Grace-Note-LLC/GraceNote/gracenote_firmware/keyboard/README.md

**Keyboard Subdirectory**

- This subdirectory contains all documentation related to the current-running firmware on GraceNote:

  (i) This README containing information about the firmware.

  (ii) The 'KeyboardMessage.ino' Arduino sketch that runs on the latest version of GraceNote.

**The Code**

- Cody
