Grace-Note-LLC/GraceNote/gracenote_hardware/atmega328p_board/altium/README.md

**Altium Subdirectory for Custom ATMega328p-AU Board**

- This subdirectory contains all design, schematic, and pcb files used for the GraceNote ATMega328p-AU board:
