Grace-Note-LLC/GraceNote/py_ui/assets/hand-removebg-preview.png

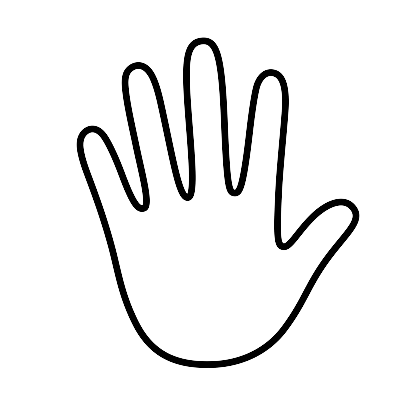
py_ui/assets/hand-removebg-preview.png
