Grace-Note-LLC/GraceNote/gracenote_hardware/esp32s3_board/altium/gracenoteESP_schematic.pdf

# Gracenote - ESP Edition

# GND¹ ²

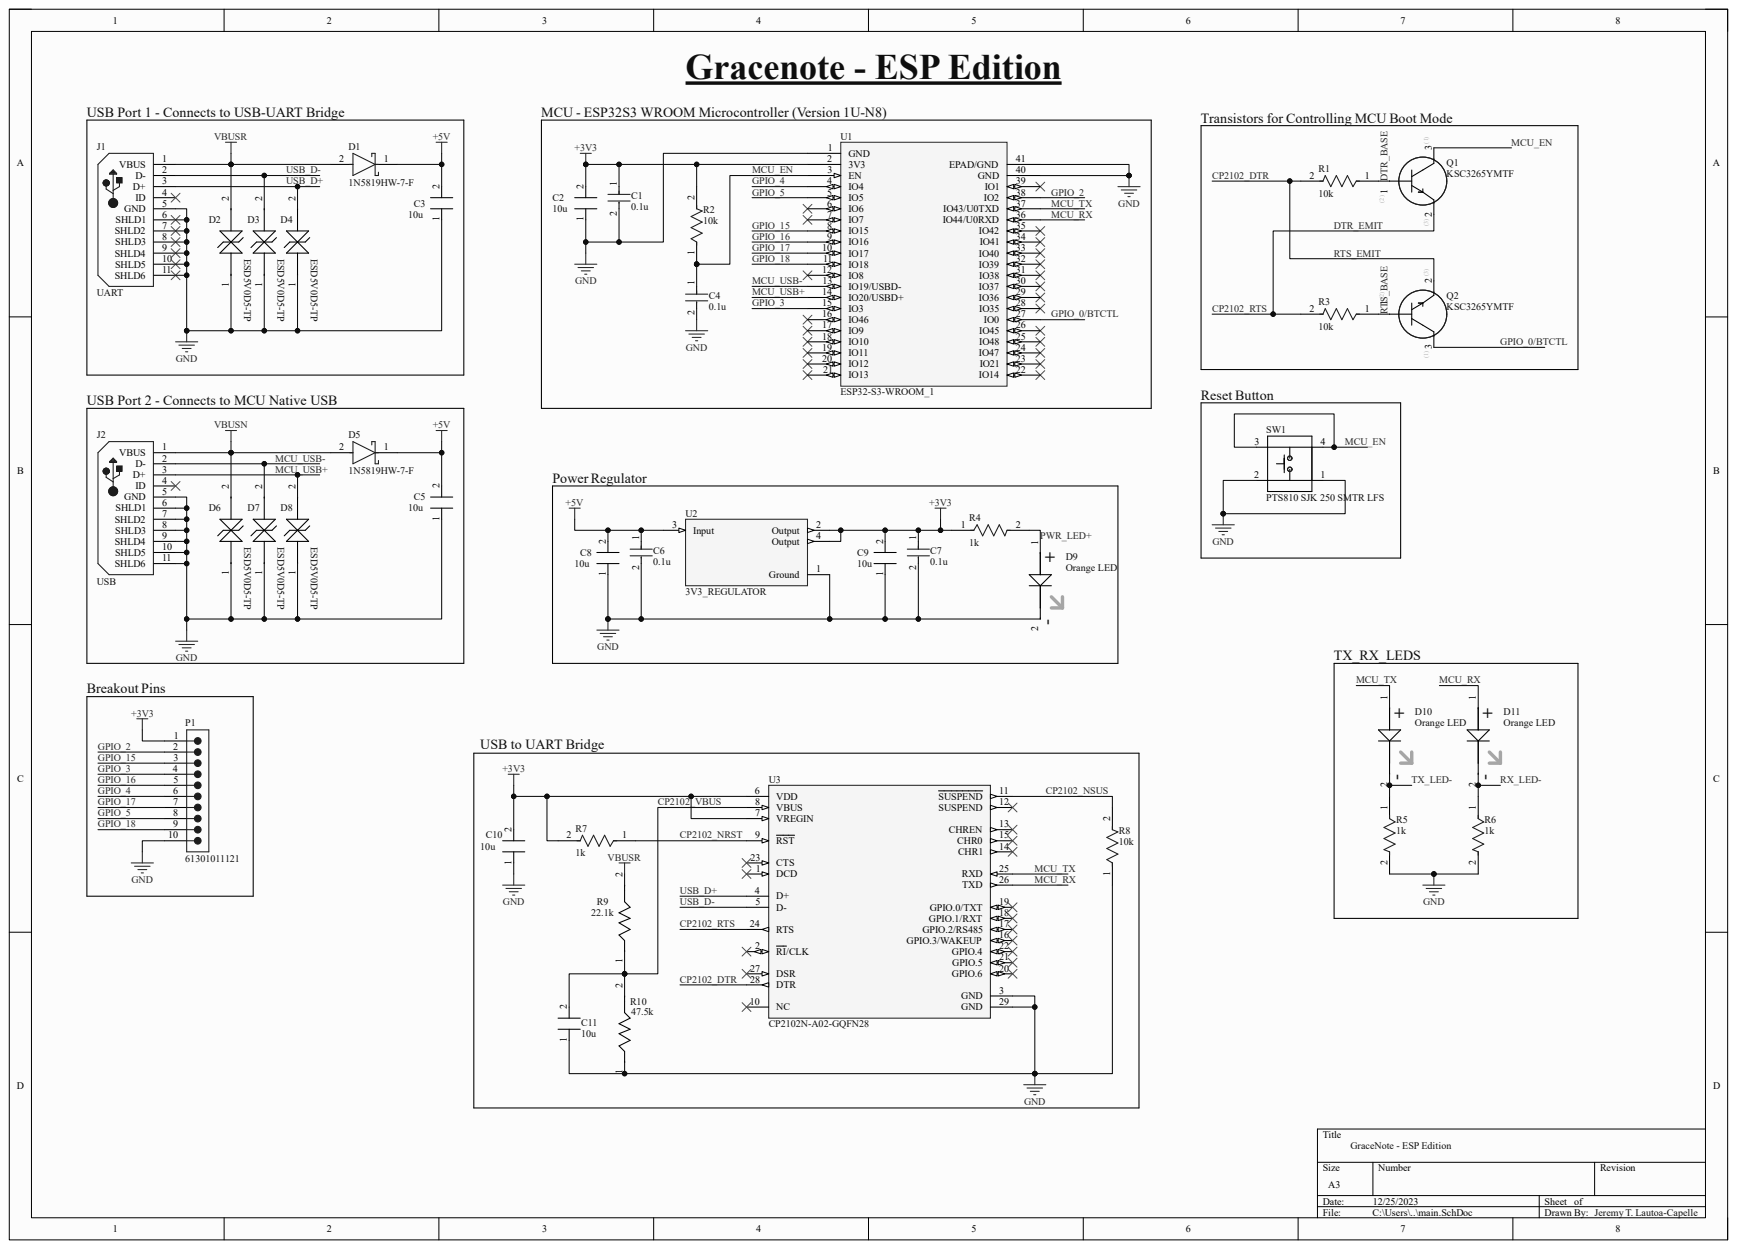
[picture p2: page 1]

USB Port 1 - Connects to USB-UART Bridge

MCU - ESP32S3 WROOM Microcontroller (Version 1U-N8)

Transistors for Controlling MCU Boot Mode
DTR_EMIT DTR_BASE RTS_BASE

USB Port 2 - Connects to MCU Native USB

USB to UART Bridge
