Grace-Note-LLC/GraceNote/gracenote_hardware/esp32s3_board/altium/gracenoteESP_PCBTOP.pdf

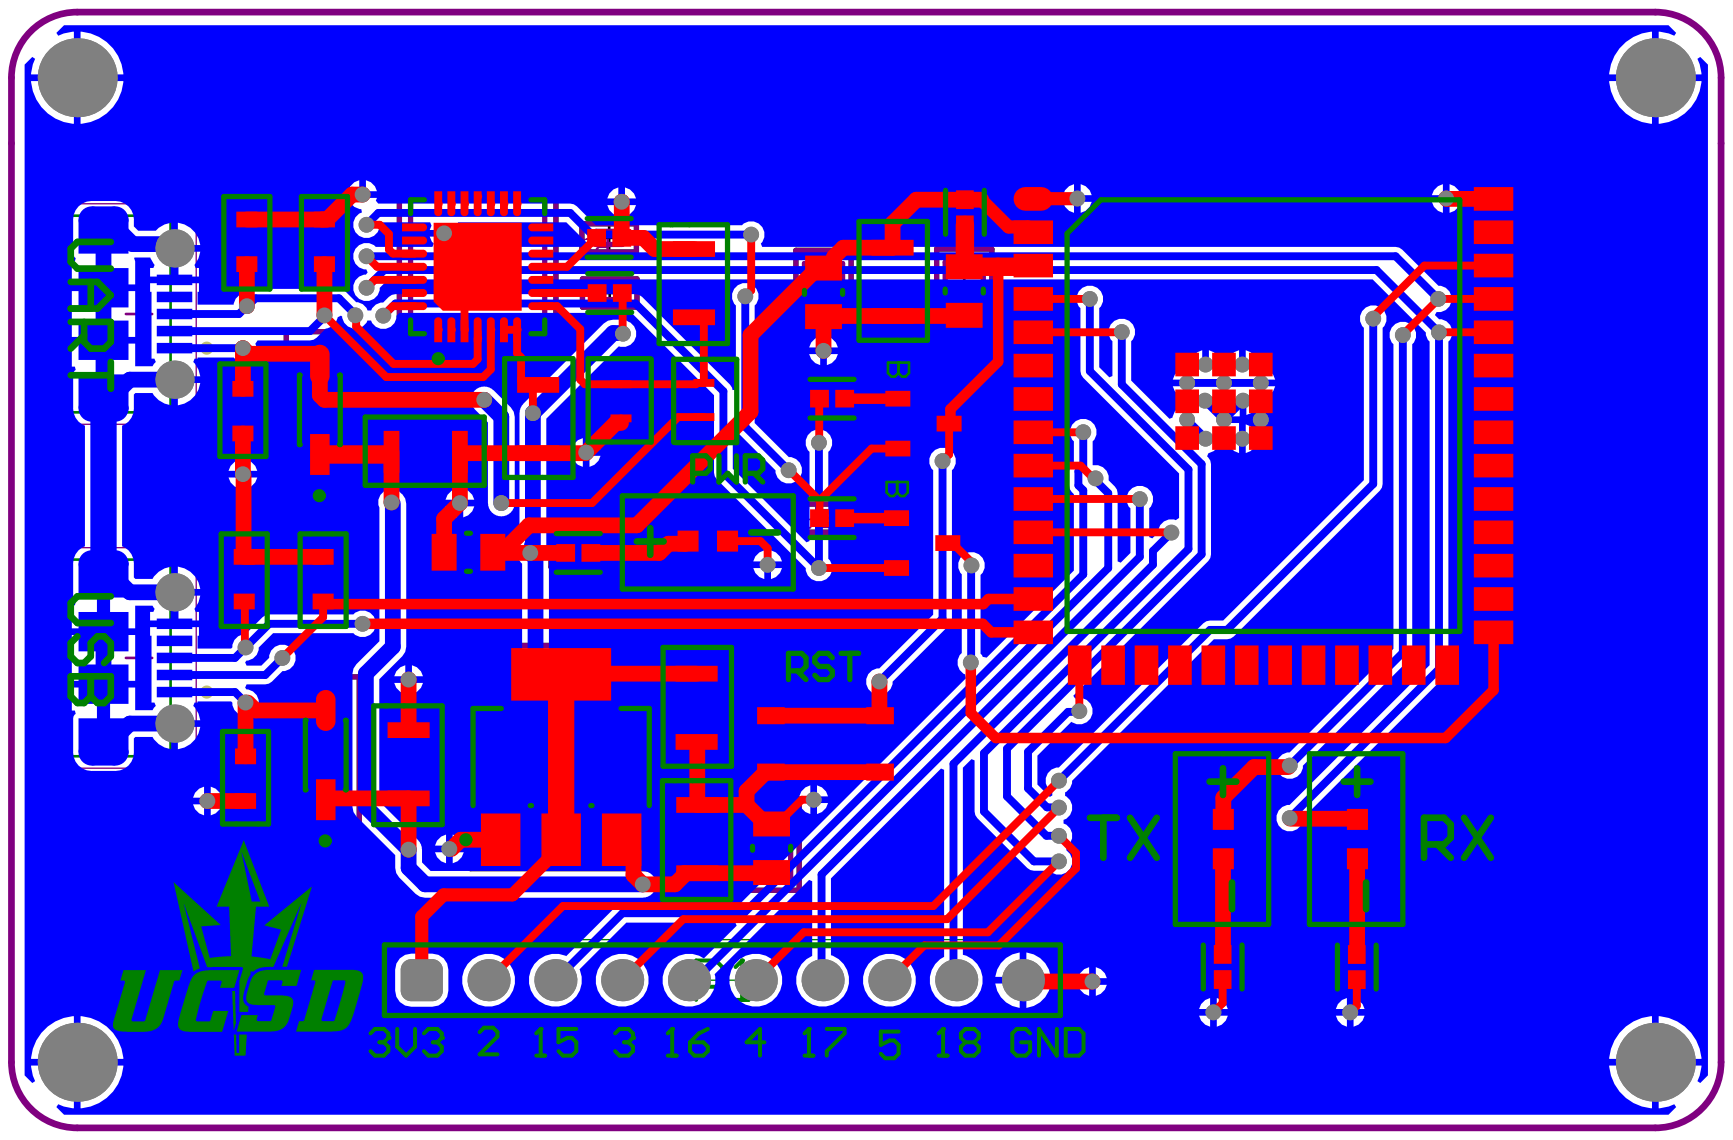
[picture p3: page 1]
