Grace-Note-LLC/GraceNote/(list of files, drawings)

Other design files:
gracenote_hardware/esp32s3_board/altium/esp32s3_wroom.PcbLib
gracenote_hardware/esp32s3_board/altium/esp32s3_wroom.SchLib
