Grace-Note-LLC/GraceNote/py_ui/portdisplays.py

import flet as ft

import serialtest
import global_var

import serial.tools.list_ports

display_box = ft.Container(
    content=ft.Text("List of Devices"), 
    padding=5,
    # bgcolor=ft.colors.RED,
    border_radius=3
)
port_list_title = ft.Container(
    content=ft.Row(controls=[
        ft.Text("Available Ports"),
        ft.Icon(
            name=ft.icons.RADIO_BUTTON_UNCHECKED,
            color=ft.colors.RED,
            size=20,
        ),
    ]),
    padding=1,
    # bgcolor=ft.colors.RED,
    border_radius=3
)
no_ports = ft.Container(
    content=ft.Text("No Devices Found"), 
    padding=5,
    bgcolor=ft.colors.RED,
    border_radius=3,
    alignment=ft.alignment.center
)

port_list = ft.ListView(padding=5, spacing=10, height=100, width=200)
port_menu = ft.Column([port_list_title, port_list], horizontal_alignment=ft.CrossAxisAlignment.CENTER)

# Loop for all available ports to find the button
def list_ports():
    print("Listing Ports")
    ports = serial.tools.list_ports.comports()
    port_list.controls.clear()
    for port, desc, _ in sorted(ports):
        if ("Bluetooth" not in "{}".format(desc)):
            print("Port Item Added: {}".format(desc))
            button = ft.ElevatedButton(
                content=ft.Text("{}: {}".format(port, desc)[0:-7], size=10),
                bgcolor=ft.colors.GREY_900,                
                on_click=lambda _, port=port: assign_port(port),
            )
            port_list.controls.append(button)
    if len(port_list.controls) == 0:
        port_list.controls.append(no_ports)

    return port_menu

# Assigns the port from a button click
# The port will be passed as a string!!!
def assign_port(port):
    print(f"\nConnect Attempt: {port}")
    try:
        global_var.ser = serial.Serial(port, global_var.baud_rate)
        # global_var.reader = serialtest.ReadLine(global_var.ser)
        print("N!O!OO!")
        print("AHAHHA")
        global_var.port_found = True
        
        print(f"Port Found: {global_var.port_found}")
        port_list_title.content.content = "Port Connected"
        global_var.page.update()

    except Exception as e:
        print(f"Attempted to Connect to Previous Port: {e}")
        list_ports()

    port_status_update()

def port_status_update():
    if global_var.port_found:
        port_list_title.content.controls[1].name = ft.icons.RADIO_BUTTON_CHECKED
        port_list_title.content.controls[1].color = ft.colors.GREEN
    else:
        port_list_title.content.controls[1].name = ft.icons.RADIO_BUTTON_UNCHECKED
        port_list_title.content.controls[1].color = ft.colors.RED
