Grace-Note-LLC/GraceNote/(commit log)

2023-10-19 add basic clicker
    adds Arduino code for the clicker module and a README to explain the device and how to use it
2023-10-22 button verication
2023-10-22 buggy button
2023-11-12 added keybinds, 5 buttons, no animations
2023-11-30 added port selector, error handling
    [hand.py, main.py, portdisplays.py]
2023-12-02 💚Got the Com button to turn green!
2023-12-03 more functionality + error dialogs
    [hand.py, main.py, portdisplays.py]
2023-12-03 added minimize button
2023-12-03 😎 Added a Theme changer icon
2023-12-03 fixed no ports dialogue
    [main.py]
2023-12-03 fixed the 6 character error that i shipped to prod
    [main.py]
2023-12-03 fixed send input dialog box, single input verify
    [hand.py, main.py]
2023-12-03 added responsive buttons + presets, fixed clear
    [hand.py, main.py]
2023-12-22 fixed major bug with device connection testing
    [main.py, portdisplays.py]
2023-12-23 fixed minor bug by adding 2 validation checks
    [hand.py, main.py]
2023-12-25 Add subdirectory for custom ESP32S3 board and README
2023-12-25 Make esp32s3 readme better
    Add pictures and more details to the esp32s3 readme
2023-12-25 Update esp32s3 readme
    spelling/grammar issues
2023-12-25 Update esp32s3 readme
    indentation
2023-12-25 Add Altium subdirectory for esp32s3 board and README
2023-12-25 Add schematic file for esp32s3 board
2023-12-25 Add BOMs for custom boards
    [GraceNote_BOMs.csv]
2023-12-25 Update esp32s3 subdir with BOM
2023-12-25 Add esp32s3 file gerbers
2023-12-25 Add PCB PDF for esp32 s3 board
2023-12-25 Add PCB Library for esp32s3 board
    [esp32s3_wroom.PcbLib]
2023-12-25 Add symbol library for esp32s3 board
    [esp32s3_wroom.SchLib]
2023-12-25 update altium readme for esp32s3 board
2023-12-25 update altium readme for esp32s3 board (spelling)
2023-12-27 Add updated BOM csv file
    [GraceNote BOMs - Sheet1.csv]
2023-12-27 Update esp32s3 readme with new PCB pictures
2023-12-27 Upload new gerbers
2023-12-27 Upload new PCB top layer traces
2023-12-27 Add README for Atmega board
2023-12-27 Add BOM to atmega subdirectory
    [GraceNote BOMs - Sheet1.csv]
2023-12-27 Add altium subdirectory and readme for atmega board
2023-12-28 update BOM file name is esp32s3 readme
2023-12-28 update esp32s3_board readme
    title
